Ryan-Myers/Arduino-Saturn-Controller/(commit log)

2021-04-27 Missed the file that was renamed
    [Arduino-Saturn-Controller.ino]
2021-04-28 Fix some mis-mapping, and change SEl0 and SEL1 to be interrupt based. Still needs lots of work.
    [Arduino-Saturn-Controller.ino]
2021-04-28 Fix B and C being swapped
    [Arduino-Saturn-Controller.ino]
2021-04-29 Fix output 3 bits
    [Arduino-Saturn-Controller.ino]
2021-04-29 Fix labeling in comments
    [Arduino-Saturn-Controller.ino]
2021-05-02 Try 3 wire protocol, probably remove it though
2021-05-04 Add some assembly code to try and eek out as much performance as possible
2021-05-05 Fix the flash script, and test unsucessfully
    [Arduino-Saturn-Controller.asm, Arduino-Saturn-Controller.ino]
2021-05-10 Add a wiring diagram
2021-05-10 Add wiring diagram for Mini USB variant
2021-05-11 Update wiring diagrams with names, and add Teensy
2021-05-31 Fix Teensy Wiring Diagram
2021-06-21 Update README.md
    Clarified RX LED, and how to use it and TX LED if needed. (Not for this project, but it comes in handy to know how.)
